mpinnuck/GarageDoorSensor/Circuit/garage-door/opener-control-schematic.png

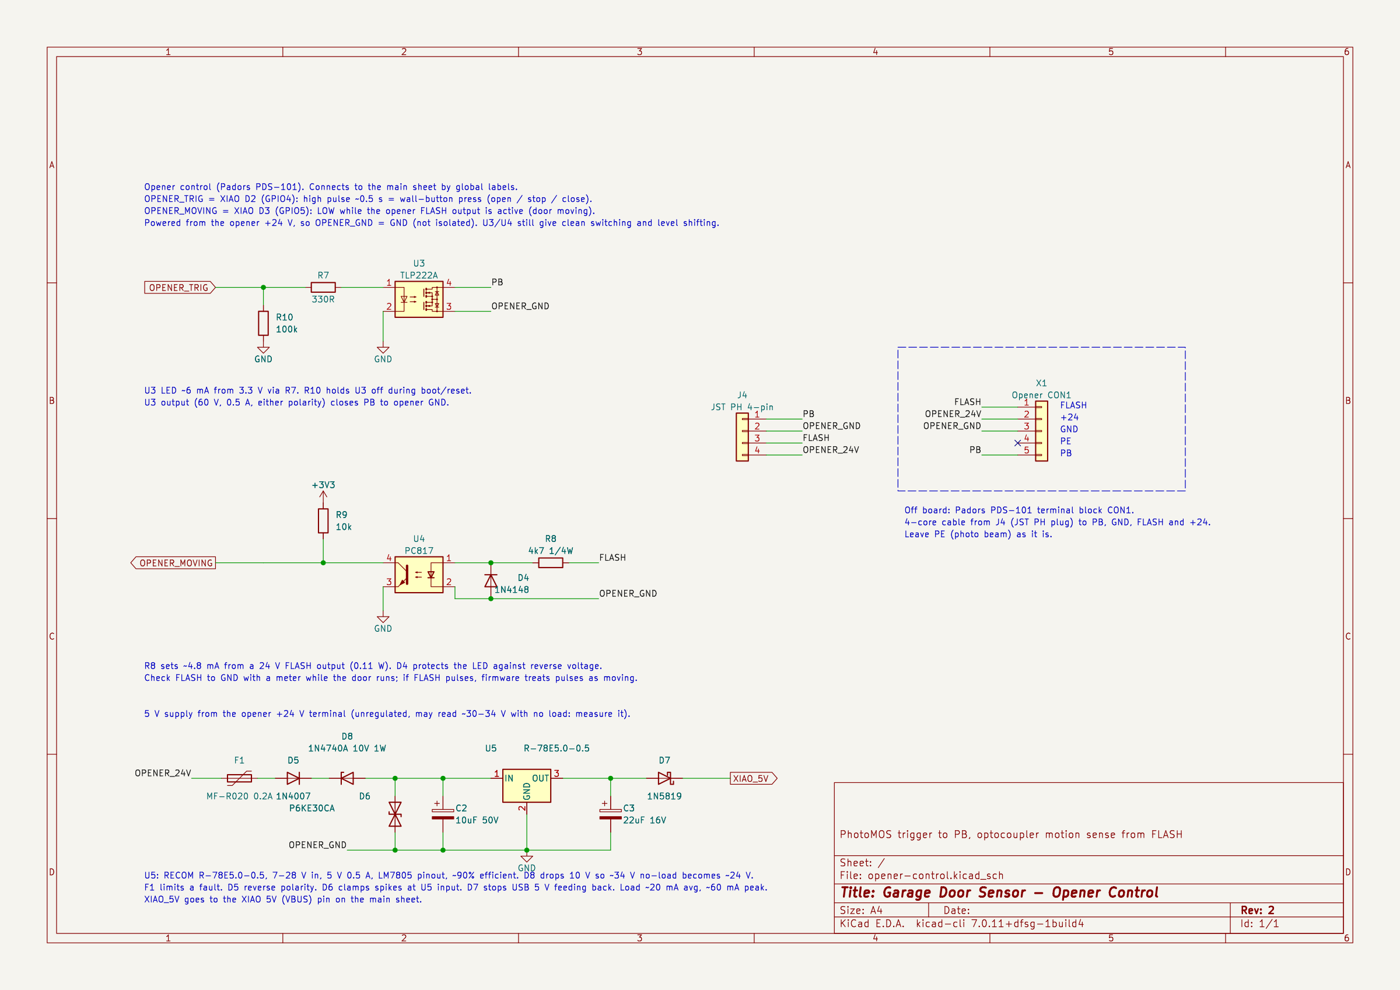
Circuit/garage-door/opener-control-schematic.png
