mpinnuck/GarageDoorSensor/Housing/GarageDoorSensor.FCStd

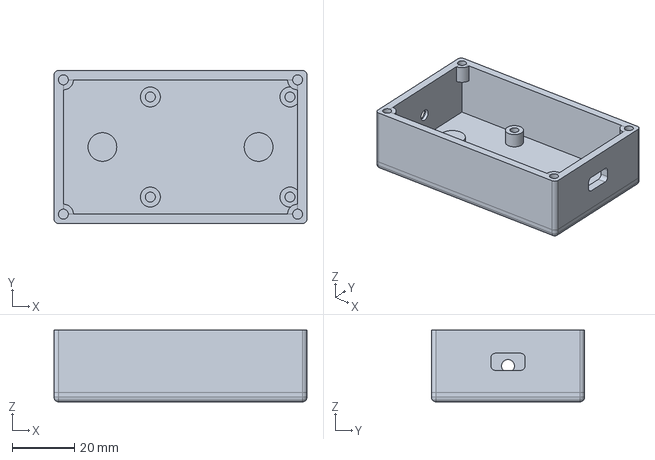
[picture p2: CAD file, 2026-10-19]
Housing/GarageDoorSensor.FCStd
81.0 x 49.0 x 23.0 mm
