mpinnuck/GarageDoorSensor/Housing/stl/Lid.stl

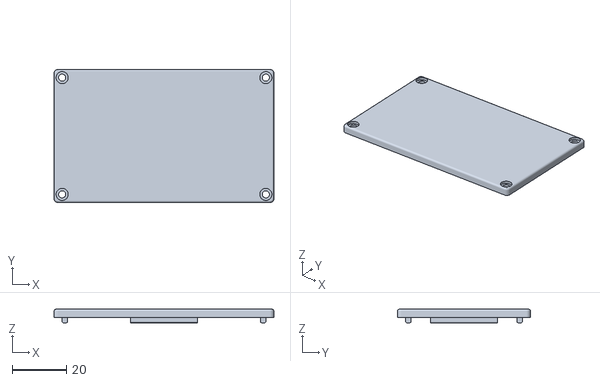
[picture p3: CAD file, 2026-10-19]
Housing/stl/Lid.stl
81.0 x 49.0 x 5.00
