mpinnuck/GarageDoorSensor/(list of files, cad)

Other CAD files:
Housing/stl/Base.stl
