mpinnuck/GarageDoorSensor/Circuit/garage-door/garage-door.kicad_pcb

## KiCad design Circuit/garage-door/garage-door.kicad_pcb (2026-10-07)

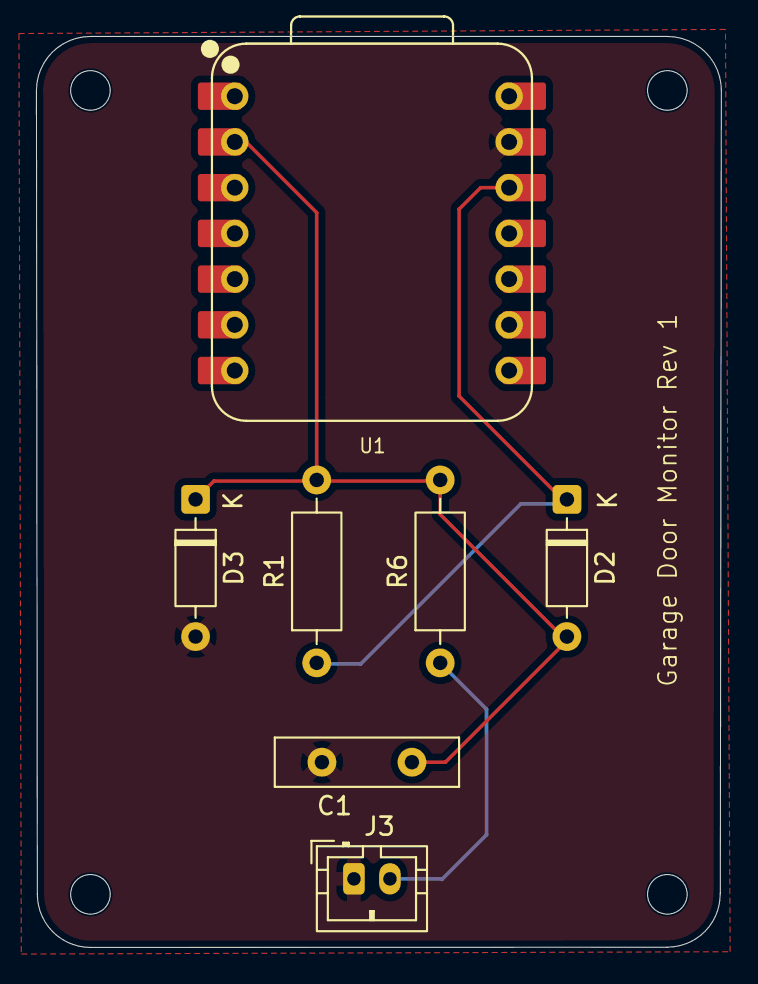
[picture p5: board garage-door.kicad_pcb from above]

Board: 2 copper layers, 38.0 x 50.6 mm, 7 parts (0 on the bottom side), 4 nets.

Parts:
C1: 100nF; C_Disc_D10.0mm_W2.5mm_P5.00mm
D2, D3: 1N4148; D_DO-35_SOD27_P7.62mm_Horizontal
J3: JST PH 2-pin; JST_PH_B2B-PH-K_1x02_P2.00mm_Vertical
R1: 10k; R_Axial_DIN0207_L6.3mm_D2.5mm_P10.16mm_Horizontal
R6: 1k; R_Axial_DIN0207_L6.3mm_D2.5mm_P10.16mm_Horizontal
U1: XIAO-ESP32-C3-DIP; XIAO-ESP32C3-DIP

Connections:
+3V3: D2.1 (K), R1.1, U1.12 (VCC_3V3)
GND: C1.2, D3.2 (A), J3.1, U1.13 (GND)
unnamed: C1.1, D2.2 (A), D3.1 (K), R1.2, R6.2, U1.2 (GPIO3/A1/D1)
unnamed: J3.2, R6.1
