mpinnuck/GarageDoorSensor/Code/GarageDoorHomeKit/include/HomeKitDoorSensor.h

// HomeKitDoorSensor.h
// HomeKit Contact Sensor service for the garage door.
// Apple Home shows it as Open / Closed, and Siri answers
// "Is the garage door open?". Call setClosed() whenever the door changes.

#pragma once

#include <HomeSpan.h>

class HomeKitDoorSensor : public Service::ContactSensor {
public:
  explicit HomeKitDoorSensor(bool closed);

  void setClosed(bool closed);

private:
  Characteristic::ContactSensorState *_state;
};
