mpinnuck/GarageDoorSensor/(commit log)

2026-10-07 Initial project snapshot
    [garage-door-B_Cu.gbl, garage-door-B_Mask.gbs, garage-door-B_Paste.gbp, garage-door-B_Silkscreen.gbo, garage-door-Edge_Cuts.gm1, garage-door-F_Cu.gtl, garage-door-F_Mask.gts, garage-door-F_Paste.gtp]
2026-10-10 v2.1.0a updated 3dprint model
    [Base.stl, GarageDoorSensor.FCStd, Lid.stl, Washer.stl]
